CircuitosCreativos/Incubadora_Huevos_Gallina/Etiqueta caja final.png

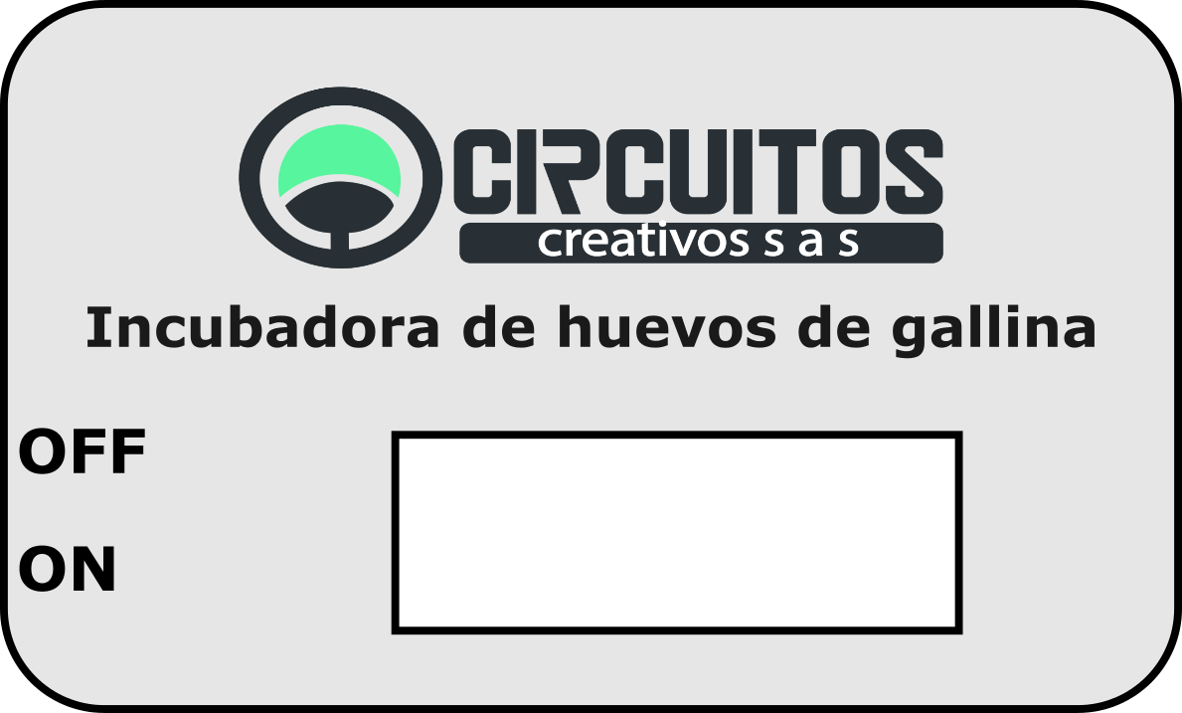
Etiqueta caja final.png
