CircuitosCreativos/Incubadora_Huevos_Gallina/(list of files, drawings)

Other design files:
Simulacion/Etapa de potencia con rele.pdsprj
