CircuitosCreativos/Incubadora_Huevos_Gallina/Eagle/Incubadora_huevos.brd

## EAGLE design Eagle/Incubadora_huevos.brd (2019-01-26)

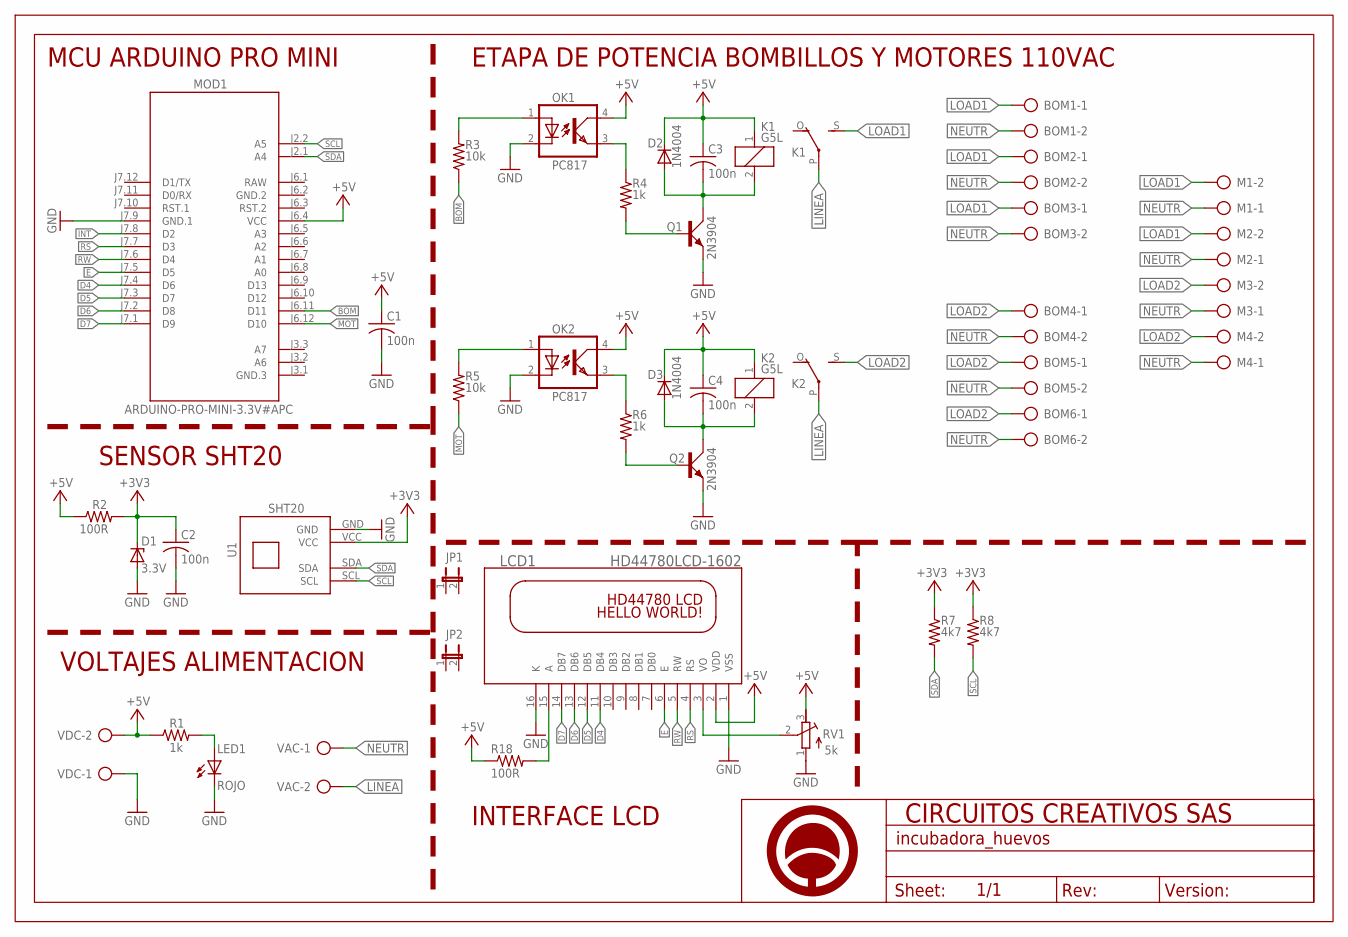
[picture p2: schematic Incubadora_huevos.sch]

Parts:
BOM1, BOM2, BOM3, BOM4, BOM5, BOM6: AK500/2
C1, C2, C3, C4: 100n; C025-025X050
D1: 3.3V; DO41Z10
D2, D3: 1N4004; DO41-10
JP1, JP2: JP1E; JP1
K1, K2: G5L; G5LE
LCD1: HD44780LCD-1602; LCD1602
LED1: ROJO; LED3MM
M1, M2, M3, M4: AK500/2
MOD1: ARDUINO-PRO-MINI-3.3V#APC; ARDUINO-PRO-MINI#APC
OK1, OK2: PC817; DIL04
Q1, Q2: 2N3904; TO92D
R1, R4, R6: 1k; 0204/7
R2, R18: 100R; 0204/7
R3, R5: 10k; 0204/7
R7, R8: 4k7; 0204/7
RV1: 5k; RTRIM3296W
U1: SHT20
U$1: A4_HORIZONTAL; LOGO
VAC: AK500/2
VDC: AK500/2

Connections:
+3V3: C2.1, D1.C, R2.2, R7.1, R8.1, U1.VCC
+5V: C1.1, C3.1, C4.1, D2.C, D3.C, K1.1, K2.1, LCD1.2 (VDD), MOD1.J6.4 (VCC), OK1.4 (COL), OK2.4 (COL), R1.1, R2.1, R18.1, RV1.3 (E), VDC.2
BOM: MOD1.J6.11 (D11), R3.1
D4: LCD1.11 (DB4), MOD1.J7.4 (D6)
D5: LCD1.12 (DB5), MOD1.J7.3 (D7)
D6: LCD1.13 (DB6), MOD1.J7.2 (D8)
D7: LCD1.14 (DB7), MOD1.J7.1 (D9)
E: LCD1.6 (E), MOD1.J7.5 (D5)
GND: C1.2, C2.2, D1.A, LCD1.1 (VSS), LCD1.16 (K), LED1.K (C), MOD1.J7.9 (GND.1), OK1.2 (C), OK2.2 (C), Q1.E, Q2.E, RV1.1 (A), U1.GND, VDC.1
GND.2: MOD1.J6.2 (GND.2)
INT: MOD1.J7.8 (D2)
LINEA: K1.P, K2.P, VAC.2
LOAD1: BOM1.1, BOM2.1, BOM3.1, K1.S, M1.2, M2.2
LOAD2: BOM4.1, BOM5.1, BOM6.1, K2.S, M3.2, M4.2
MOT: MOD1.J6.12 (D10), R5.1
unnamed: LED1.A, R1.2
unnamed: OK1.3 (EMIT), R4.1
unnamed: Q1.B, R4.2
unnamed: OK1.1 (A), R3.2
unnamed: C4.2, D3.A, K2.2, Q2.C
unnamed: OK2.3 (EMIT), R6.1
unnamed: Q2.B, R6.2
unnamed: OK2.1 (A), R5.2
unnamed: C3.2, D2.A, K1.2, Q1.C
unnamed: LCD1.3 (VO), RV1.2 (S)
unnamed: LCD1.15 (A), R18.2
NEUTR: BOM1.2, BOM2.2, BOM3.2, BOM4.2, BOM5.2, BOM6.2, M1.1, M2.1, M3.1, M4.1, VAC.1
RAW: MOD1.J6.1 (RAW)
RS: LCD1.4 (RS), MOD1.J7.7 (D3)
RW: LCD1.5 (RW), MOD1.J7.6 (D4)
SCL: MOD1.J2.2 (A5), R8.2, U1.SCL
SDA: MOD1.J2.1 (A4), R7.2, U1.SDA

Notes on the sheet:
SENSOR SHT20
MCU ARDUINO PRO MINI
VOLTAJES ALIMENTACION
ETAPA DE POTENCIA BOMBILLOS Y MOTORES 110VAC
INTERFACE LCD

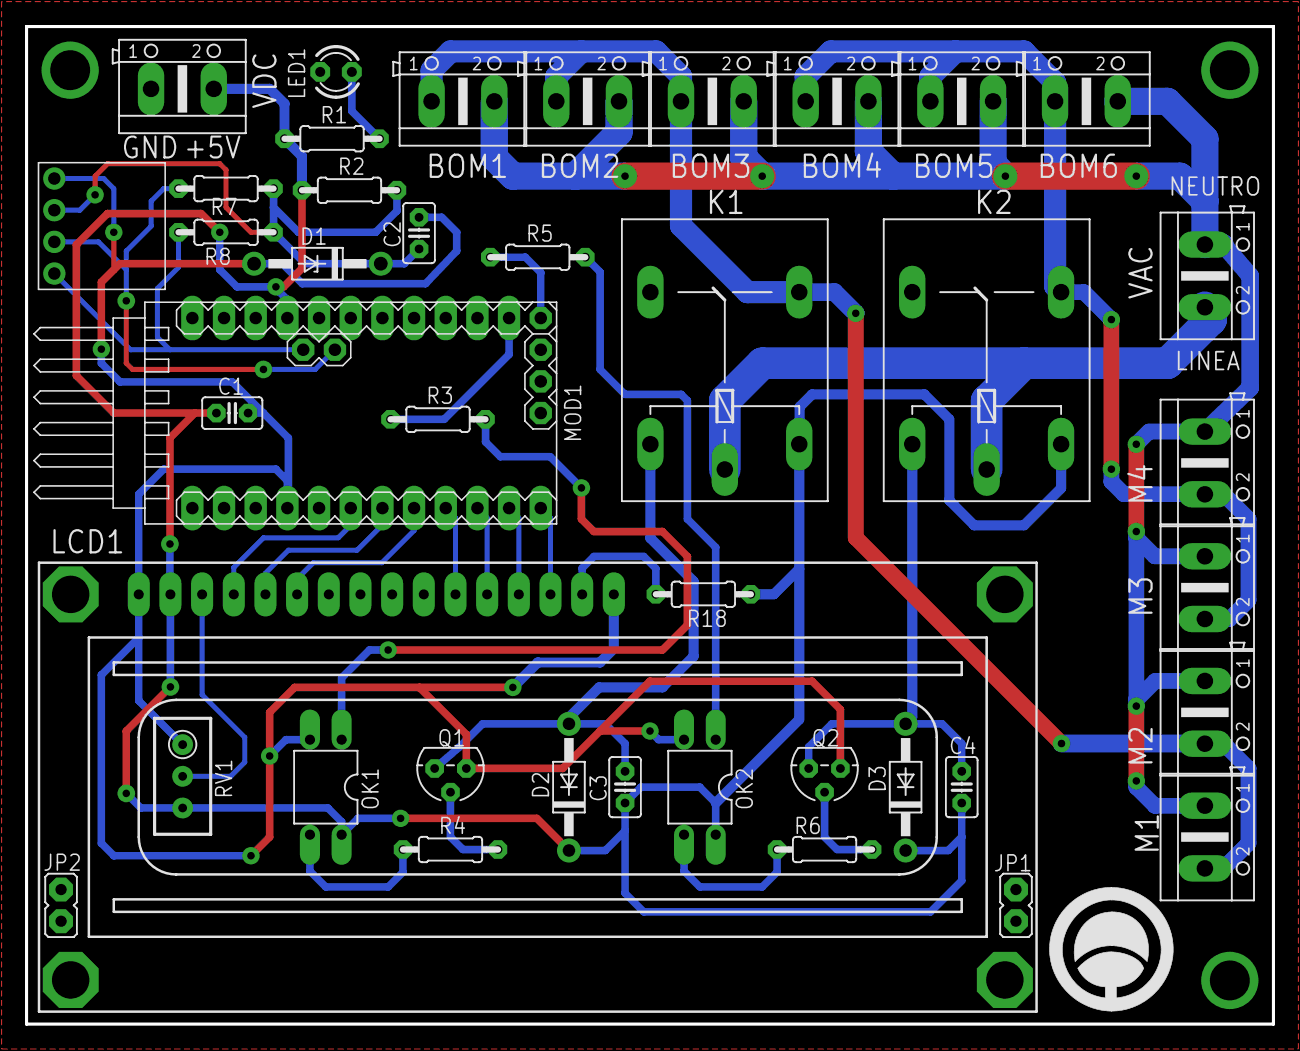
[picture p3: board Incubadora_huevos.brd from above]

Board: 2 copper layers, 100.0 x 80.0 mm, 42 parts (0 on the bottom side), 29 nets.
