CircuitosCreativos/Incubadora_Huevos_Gallina/Firmware/Incubadora_huevos_gallina/Descriptors.h

#ifndef __Descriptors_H__
#define __Descriptors_H__

//Definimos los pines necesarios para controlar el hardware
//pines display LCD
#define COLUMNA   16    
#define FILA      2
#define RS        3
#define RW        4
#define EN        5
#define D4        6
#define D5        7
#define D6        8
#define D7        9

//pines control bombillos y motores
#define MOT       10
#define BOM       11

//Pin datos sensor DS18B20
#define WIRE_BUS  18

//parametros constantes
#define TEMP_MAX  38.2
#define TEMP_MIN  37.2

#endif
