CircuitosCreativos/Incubadora_Huevos_Gallina/(commit log)

2018-09-25 Terminado SCH circuito basico ON-OFF
    [Incubadora_huevos.sch]
2018-09-25 Inicio BRD, ubicando componentes
    [Incubadora_huevos.brd, Incubadora_huevos.sch]
2018-09-26 Terminado ubicacion componentes. inicio ruteo
    [Incubadora_huevos.brd, Incubadora_huevos.sch]
2018-12-12 Terminado BRD, listo para fabricar
    [Incubadora_huevos.brd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]
2018-12-12 Se modifico la etapa de potencia ya que la anterior se calentaba mucho
    [Incubadora_huevos.brd, Incubadora_huevos.sch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]
2019-01-26 Subido Firmware para el microcontrolador
    [Incubadora_huevos.brd, Incubadora_huevos.sch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]
2019-01-26 Subido archivos restantes version 1.0
    [Etapa de potencia con rele.pdsprj]
2019-01-26 Cambio sensor SHT20 por DS18B20, por problemas de distancia en I2C
    [Descriptors.h, Incubadora_huevos_gallina.ino, Visual.ino]
2019-01-26 Se agrego resistencias pull up a la PCB
    [Incubadora_huevos.brd, Incubadora_huevos.sch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]
2019-01-26 Se agrego rutina falla de conexion sensor
